De93/Gli-Heroes/GUI_sensors/legno1.png

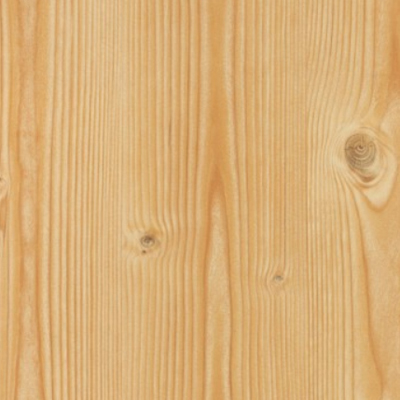
GUI_sensors/legno1.png
