De93/Gli-Heroes/GUI_sensors/guitar_hero.png

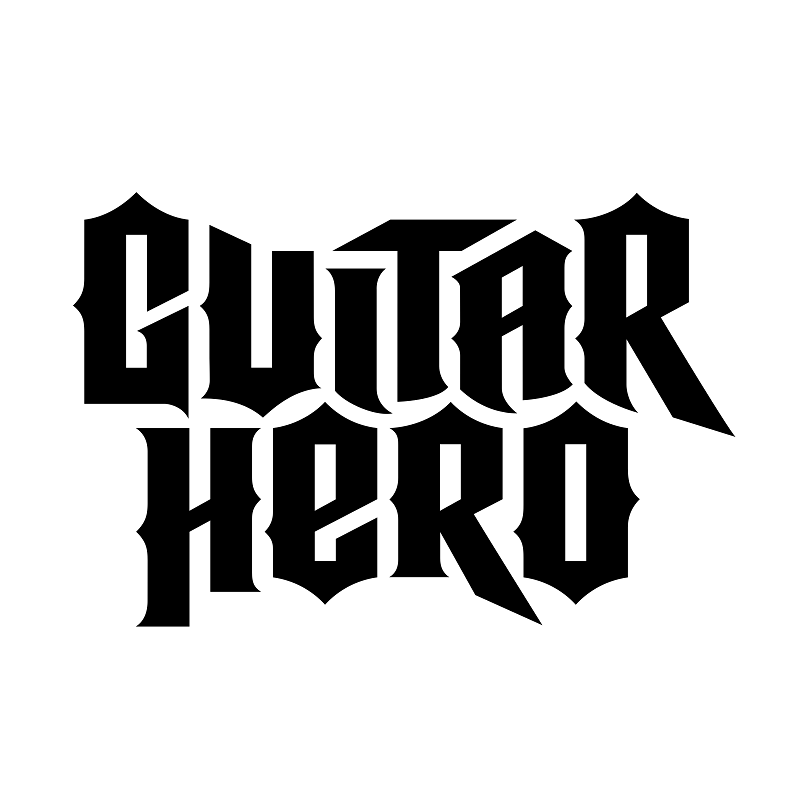
GUI_sensors/guitar_hero.png
