De93/Gli-Heroes/(list of files, drawings)

Other design files:
fritzing_guitarHero.fzz
