De93/Gli-Heroes/(commit log)

2017-04-25 Arduino: aggiunto file da caricare su Arduino per comunicazione seriale
2017-05-10 Modificato il range dei rettangoli gialli e modificato riga codice riguardante l'accesso alla porta seriale (my port)
2017-06-06 modificato cursore, ora è analogo ai rettangoli che c'erano precedentemente, ma sono cerchi posizionati sulle corde - aggiunta trasparenza ma problema sfarfallio
    [GUI_sensors.pde]
2017-06-07 Aggiunti led, pulsante e contatore score
2017-06-07 Migliorata accensione led, ma comunque da migliorare velocità risposta led
2017-06-08 Aggiunto file fritzing
    [fritzing_guitarHero.fzz]
2017-06-18 Update GUI_sensors.pde
    risolto problema dello STOP
    [GUI_sensors.pde]
2017-06-18 Migliorata risposta led e resettato pulsante e score
    [GUI_sensors.pde]
2017-06-19 migliorata velocità pallini, ridotta pesantezza programma usando refresh selettivo
2017-07-13 modificato file fritzing
    [fritzing_guitarHero.fzz]
